CelestineOverflow/Afterburner_PCB/afterburner.kicad_pcb

## KiCad design afterburner.kicad_pcb (2025-08-22)

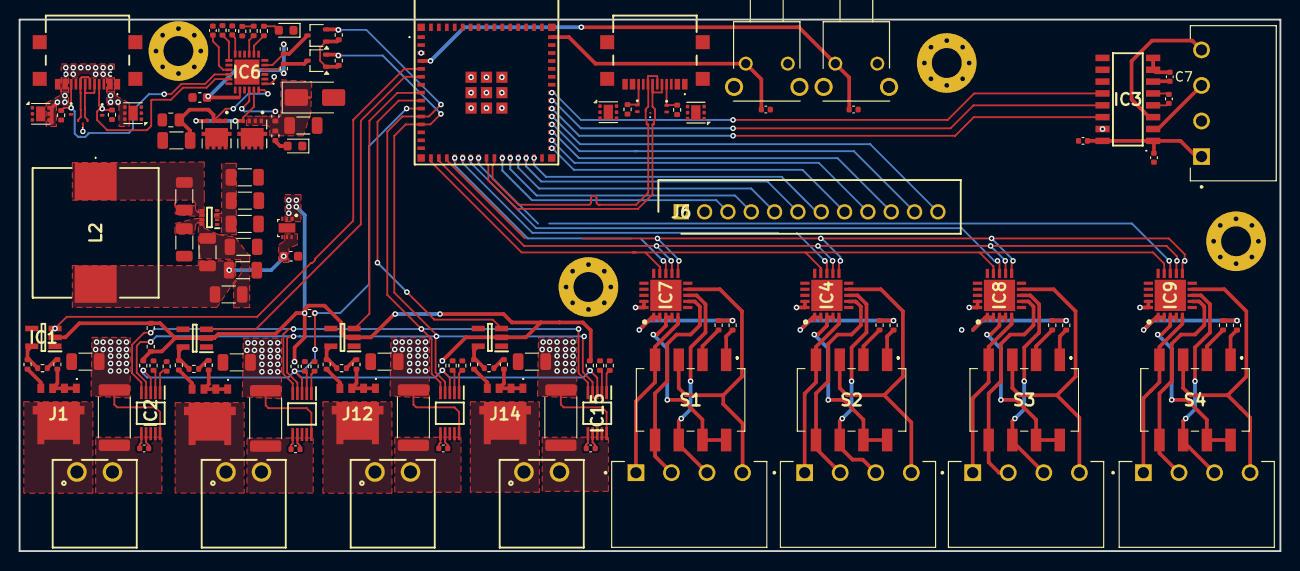
[picture p2: board afterburner.kicad_pcb from above]

Board: 4 copper layers, 135.1 x 56.9 mm, 144 parts (0 on the bottom side), 133 nets.

Parts:
C3, C16, C18, C19, C21, C23: 100nF; C_0402_1005Metric
C4, C20, C22, C24: 4.7uF; C_1206_3216Metric
C5, C6, C7, C8: 1uF; C_0402_1005Metric
C9: 10uF; C_1206_3216Metric
C10, C11: 100nF; C_1206_3216Metric
C12, C15: 10u; C_1206_3216Metric
C13, C25: 33nF; C_1206_3216Metric
C14: 15pF; C_1206_3216Metric
C17: 1u; C_0603_1608Metric
C26: 10uF; C_0603_1608Metric
C27, C28: C; C_0402_1005Metric
Cout1: 100uF; C_1206_3216Metric
D1, D2: ESD122DMYR
D3, D5: RED; LED_0603_1608Metric
D4: D_Schottky; D_SMA
H1, H2, H4, H5: MountingHole_Pad; MountingHole_3.2mm_M3_Pad_Via
IC1, IC10, IC12, IC14: MCP1416T-E_OT; SOT95P270X145-5N
IC2, IC11, IC13, IC15: INA226AIDGSR; SOP50P490X110-10N
IC3: NAU7802SGI; SOIC127P600X175-16N
IC4, IC7, IC8, IC9: MAX31865ATP+T; QFN65P500X500X80-21N
IC5: TPS62933DRLR; SOTFL50P160X60-8N
IC6: AP33772SDKZ-13-FA01; AP33772SDKZ13FA01
IC16: ESP32-S3-MINI-1-N8; ESP32S3MINI1N8
IC17: XC6220B331ER-G; XC6220B331ERG
J1, J10, J12, J14: NTMFS5C612NLT1G
J2, J11, J13, J15: 691322310002
J3, J17, J18, J19, J20: 1803293; PHOENIX_1803293
J5, J16: UJ20-C-H-G-SMT-5-P16-TR; UJ20CHGSMT5P16TR
J6: B12B-XH-A_LF__SN_; SHDR12W64P0X250_1X12_3240X575X700P
L2: SRP1250-7R8M; SRP12507R8M
Q1, Q2: BSS138; SOT-323_SC-70
R3, R33, R40, R47: 30mΩ; R_2512_6332Metric
R4, R5, R6, R7, R8, R9, R19, R26, R34, R35, R36, R37, R38, R39, R41, R42, R43, R44, R45, R46, R48, R49, R50, R51, R52, R53, R55: 10k; R_0402_1005Metric
R10, R27, R29, R31: 430; R_0402_1005Metric
R11, R28, R30, R32: 4.3k; R_0402_1005Metric
R12, R13, R14, R16, R20, R21, R22, R23, R24, R25: 5.1k; R_0402_1005Metric
R15, R54: 4.7k; R_0402_1005Metric
R17: 5m; R_0805_2012Metric
R18: 27R; R_0402_1005Metric
Rfbb1: 10k; R_1206_3216Metric
Rfbt1: 52.3k; R_1206_3216Metric
S1, S2, S3, S4: 219-4MST; 2194MST
S5, S6: 1-1825027-1; SW_1-1825027-1
TH1: Thermistor_NTC; R_0402_1005Metric
U2, U5, U6, U9: TVS2200DRV; WSON-6-1EP_2x2mm_P0.65mm_EP1x1.6mm
U3, U4, U7, U8: TPD1E05U06DPY; Texas_DPY0002A_0.6x1mm_P0.65mm
U10, U11: AON7262E; TRANS_AONR21307

Connections:
+3.3V: Q1.1 (G), Q2.1 (G), R21.1, R22.1
+3V3: C3.1, C19.1, C21.1, C23.1, IC1.2 (VDD), IC2.6 (VS), IC3.15 (DVDD), IC4.19 (DVDD), IC4.20 (VDD), IC7.19 (DVDD), IC7.20 (VDD), IC8.19 (DVDD), IC8.20 (VDD), IC9.19 (DVDD), IC9.20 (VDD), IC10.2 (VDD), IC11.6 (VS), IC12.2 (VDD), IC13.6 (VS), IC14.2 (VDD), IC15.6 (VS), IC16.3 (3V3), IC17.1 (VOUT_1), IC17.2 (VOUT_2), J6.1, R9.2, R15.2, R39.2, R46.2, R53.2, R54.2, R55.2
+5V: C14.1, C26.2, Cout1.1, IC17.3 (CE), IC17.5 (VIN_1), IC17.6 (VIN_2), L2.2, Rfbt1.1
/ALERT_INT: IC2.3 (ALERT), IC11.3 (ALERT), IC13.3 (ALERT), IC15.3 (ALERT), IC16.10 (IO6), R9.1, R39.1, R46.1, R53.1, R55.1
/D+: D1.3 (IO2), IC16.24 (IO20), J5.A6 (DP1), J5.B6 (DP2)
/D-: D1.2 (IO1), IC16.23 (IO19), J5.A7 (DN1), J5.B7 (DN2)
/HEATER_PWM_1: IC1.3 (IN), IC16.5 (IO1)
/HEATER_PWM_2: IC10.3 (IN), IC16.6 (IO2)
/HEATER_PWM_3: IC12.3 (IN), IC16.8 (IO4)
/HEATER_PWM_4: IC14.3 (IN), IC16.9 (IO5)
/Heater_Mosfet_1/IN-: IC2.9 (IN-), J2.2, R3.1
/Heater_Mosfet_1/OUT_MOS: J1.5 (D_1), J1.6 (D_2), J1.7 (D_3), J1.8 (D_4), J1.9 (D_5), J2.1
/Heater_Mosfet_2/IN-: IC11.9 (IN-), J11.2, R33.1
/Heater_Mosfet_2/OUT_MOS: J10.5 (D_1), J10.6 (D_2), J10.7 (D_3), J10.8 (D_4), J10.9 (D_5), J11.1
/Heater_Mosfet_3/IN-: IC13.9 (IN-), J13.2, R40.1
/Heater_Mosfet_3/OUT_MOS: J12.5 (D_1), J12.6 (D_2), J12.7 (D_3), J12.8 (D_4), J12.9 (D_5), J13.1
/Heater_Mosfet_4/IN-: IC15.9 (IN-), J15.2, R47.1
/Heater_Mosfet_4/OUT_MOS: J14.5 (D_1), J14.6 (D_2), J14.7 (D_3), J14.8 (D_4), J14.9 (D_5), J15.1
/LCD_BL: IC16.31 (IO35), J6.8
/LCD_CS: IC16.27 (IO47), J6.5
/LCD_DC: IC16.28 (IO33), J6.6
/LCD_RST: IC16.29 (IO34), J6.7
/LCD_SCL: IC16.26 (IO26), J6.4
/LCD_SDA: IC16.25 (IO21), J6.3
/LDCL_DRDY: IC3.12 (DRDY), IC16.38 (IO42)
/LDCL_SCLK: IC3.13 (SCLK), IC16.37 (IO41)
/LDCL_SDIO: IC3.14 (SDIO), IC16.36 (IO40)
/MCU/BOOT: C27.2, IC16.4 (IO0), S5.2
/MCU/ENABLE: C28.2, IC16.45 (EN), S6.2
/MISO: IC4.14 (SDO), IC7.14 (SDO), IC8.14 (SDO), IC9.14 (SDO), IC16.16 (IO12)
/MOSI: IC4.11 (SDI), IC7.11 (SDI), IC8.11 (SDI), IC9.11 (SDI), IC16.18 (IO14)
/PD/CC1: IC6.17 (CC1), J16.A5 (CC1), R14.1, U7.1 (I/O)
/PD/CC2: IC6.16 (CC2), J16.B5 (CC2), R16.1, U8.1 (I/O)
/PD/IFB: C16.1, IC6.15 (IFB)
/PD/NTC: IC6.13 (OTP), TH1.1
/PD/PD_INT: R25.2, R26.1
/PD/PD_INT_5V: IC6.9 (INT), R25.1
/PD/PD_LED: IC6.8 (LED), R20.1
/PD/PWR_EN: IC6.23 (PWR_EN), U10.4, U11.4
/PD/SCL_5V: IC6.5 (SCL), Q1.3 (D), R23.2
/PD/SDA_5V: IC6.4 (SDA), Q2.3 (D), R24.2
/PD/USB_N: D2.2 (IO1), J16.A7 (DN1), J16.B7 (DN2)
/PD/USB_P: D2.3 (IO2), J16.A6 (DP1), J16.B6 (DP2)
/PD/V5V: C17.1, IC6.20 (V5V), R23.1, R24.1
/PD/V18: C18.1, IC6.12 (V18)
/PD/VBUS: IC6.1 (ISENP), J16.A4 (VBUS_1), J16.B4 (VBUS_2), R17.1, U6.4 (IN), U6.5 (IN), U6.6 (IN), U9.4 (IN), U9.5 (IN), U9.6 (IN)
/PD/VBUS_SENSED: C12.1, IC6.24 (VCC), R17.2, U10.1, U10.2, U10.3
/PD/VCC: C9.2, C10.1, C15.1, C25.1, D4.1 (K), IC5.3 (VIN), R18.2, R19.1, U11.1, U11.2, U11.3
/PD/VOUT: IC6.22 (VOUT), R18.1
/SCK: IC4.12 (SCLK), IC7.12 (SCLK), IC8.12 (SCLK), IC9.12 (SCLK), IC16.17 (IO13)
/SCL: IC2.5 (SCL), IC11.5 (SCL), IC13.5 (SCL), IC15.5 (SCL), IC16.11 (IO7), Q1.2 (S), R15.1, R21.2
/SDA: IC2.4 (SDA), IC11.4 (SDA), IC13.4 (SDA), IC15.4 (SDA), IC16.12 (IO8), Q2.2 (S), R22.2, R54.1
/SS1: IC7.13 (~CS), IC16.19 (IO15)
/SS2: IC4.13 (~CS), IC16.20 (IO16)
/SS3: IC8.13 (~CS), IC16.21 (IO17)
/SS4: IC9.13 (~CS), IC16.22 (IO18)
/TP_IRQ: IC16.35 (IO39), J6.12
/TP_RST: IC16.34 (IO38), J6.11
/TP_SCL: IC16.33 (IO37), J6.10
/TP_SDA: IC16.32 (IO36), J6.9
/Temp Sensor 1/430R: R10.1, S1.2
/Temp Sensor 1/4300R: R11.1, S1.1
/Temp Sensor 1/FORCE_N: IC7.9 (FORCE-), J18.04, S1.3
/Temp Sensor 1/FORCE_P: IC7.5 (FORCE+), J18.01, S1.4
/Temp Sensor 1/ISENSOR: IC7.3 (REFIN-), IC7.4 (ISENSOR), S1.7, S1.8
/Temp Sensor 1/RTDIN_N: IC7.8 (RTDIN-), J18.03, S1.6
/Temp Sensor 1/RTDIN_P: IC7.7 (RTDIN+), J18.02, S1.5
/Temp Sensor 2/430R: R27.1, S2.2
/Temp Sensor 2/4300R: R28.1, S2.1
/Temp Sensor 2/FORCE_N: IC4.9 (FORCE-), J17.04, S2.3
/Temp Sensor 2/FORCE_P: IC4.5 (FORCE+), J17.01, S2.4
/Temp Sensor 2/ISENSOR: IC4.3 (REFIN-), IC4.4 (ISENSOR), S2.7, S2.8
/Temp Sensor 2/RTDIN_N: IC4.8 (RTDIN-), J17.03, S2.6
/Temp Sensor 2/RTDIN_P: IC4.7 (RTDIN+), J17.02, S2.5
/Temp Sensor 3/430R: R29.1, S3.2
/Temp Sensor 3/4300R: R30.1, S3.1
/Temp Sensor 3/FORCE_N: IC8.9 (FORCE-), J19.04, S3.3
/Temp Sensor 3/FORCE_P: IC8.5 (FORCE+), J19.01, S3.4
/Temp Sensor 3/ISENSOR: IC8.3 (REFIN-), IC8.4 (ISENSOR), S3.7, S3.8
/Temp Sensor 3/RTDIN_N: IC8.8 (RTDIN-), J19.03, S3.6
/Temp Sensor 3/RTDIN_P: IC8.7 (RTDIN+), J19.02, S3.5
/Temp Sensor 4/430R: R31.1, S4.2
/Temp Sensor 4/4300R: R32.1, S4.1
/Temp Sensor 4/FORCE_N: IC9.9 (FORCE-), J20.04, S4.3
/Temp Sensor 4/FORCE_P: IC9.5 (FORCE+), J20.01, S4.4
/Temp Sensor 4/ISENSOR: IC9.3 (REFIN-), IC9.4 (ISENSOR), S4.7, S4.8
/Temp Sensor 4/RTDIN_N: IC9.8 (RTDIN-), J20.03, S4.6
/Temp Sensor 4/RTDIN_P: IC9.7 (RTDIN+), J20.02, S4.5
/USB _CONTROL/CC1: J5.A5 (CC1), R12.1, U3.1 (I/O)
/USB _CONTROL/CC2: J5.B5 (CC2), R13.1, U4.1 (I/O)
/USB _CONTROL/VBUS: J5.A4 (VBUS_1), J5.B4 (VBUS_2), U2.4 (IN), U2.5 (IN), U2.6 (IN), U5.4 (IN), U5.5 (IN), U5.6 (IN)
GND: C3.2, C4.2, C5.2, C7.2, C8.2, C9.1, C10.2, C12.2, C13.1, C15.2, C16.2, C17.2, C18.2, C19.2, C20.2, C21.2, C22.2, C23.2, C24.2, C25.2, C26.1, C27.1, C28.1, Cout1.2, D1.1 (GROUND), D2.1 (GROUND), D3.1 (K), D4.2 (A), D5.1 (K), H1.1, H2.1, H4.1, H5.1, IC1.4 (GND), IC2.7 (GND), IC3.7 (REFN), IC3.8 (AVSS), IC3.9 (DVSS), IC4.6 (FORCE2), IC4.10 (GND2), IC4.15 (DGND), IC4.16 (GND1), IC4.21 (EP), IC5.4 (GND), IC6.3 (GND_1), IC6.25 (GND_2), IC7.6 (FORCE2), IC7.10 (GND2), IC7.15 (DGND), IC7.16 (GND1), IC7.21 (EP), IC8.6 (FORCE2), IC8.10 (GND2), IC8.15 (DGND), IC8.16 (GND1), IC8.21 (EP), IC9.6 (FORCE2), IC9.10 (GND2), IC9.15 (DGND), IC9.16 (GND1), IC9.21 (EP), IC10.4 (GND), IC11.7 (GND), IC12.4 (GND), IC13.7 (GND), IC14.4 (GND), IC15.7 (GND), IC16.1 (GND_1), IC16.2 (GND_2), IC16.42 (GND_3), IC16.43 (GND_4), IC16.46 (GND_5), IC16.47 (GND_6), IC16.48 (GND_7), IC16.49 (GND_8), IC16.50 (GND_9), IC16.51 (GND_10), IC16.52 (GND_11), IC16.53 (GND_12), IC16.54 (GND_13), IC16.55 (GND_14), IC16.56 (GND_15), IC16.57 (GND_16), IC16.58 (GND_17), IC16.59 (GND_18), IC16.60 (GND_19), IC16.61 (GND_20), IC16.62 (GND_21), IC16.63 (GND_22), IC16.64 (GND_23), IC16.65 (GND_24), IC16.66 (GND_25), IC16.67 (GND_26), IC16.68 (GND_27), IC16.69 (GND_28), IC16.70 (GND_29), IC16.71 (GND_30), IC16.72 (GND_31), IC16.73 (GND_32), IC17.4 (VSS), IC17.7 (EP), J3.02, J5.A1 (GND_1), J5.B1 (GND_2), J5.MP1, J5.MP2, J5.MP3, J5.MP4, J6.2, J16.A1 (GND_1), J16.B1 (GND_2), J16.MP1, J16.MP2, J16.MP3, J16.MP4, R7.2, R8.2, R12.2, R13.2, R14.2, R16.2, R26.2, R37.2, R38.2, R44.2, R45.2, R51.2, R52.2, Rfbb1.2, S5.1, S6.1, TH1.2, U2.1 (GND), U2.2 (GND), U2.3 (GND), U2.7 (GND), U3.2 (GND), U4.2 (GND), U5.1 (GND), U5.2 (GND), U5.3 (GND), U5.7 (GND), U6.1 (GND), U6.2 (GND), U6.3 (GND), U6.7 (GND), U7.2 (GND), U8.2 (GND), U9.1 (GND), U9.2 (GND), U9.3 (GND), U9.7 (GND)
unnamed: D3.2 (A), R19.2
unnamed: D5.2 (A), R20.2
unnamed: IC1.5 (OUT), R4.1, R5.1
unnamed: IC2.2 (A0), R8.1
unnamed: IC2.1 (A1), R7.1
unnamed: C5.1, C8.1, IC3.1 (REFP), IC3.16 (AVDD/LDO), J3.01
unnamed: C7.1, IC3.6 (VBG)
unnamed: IC3.2 (VIN1N), J3.03
unnamed: IC3.3 (VIN1P), J3.04
unnamed: C6.1, IC3.4 (VIN2N)
unnamed: C6.2, IC3.5 (VIN2P)
unnamed: IC4.1 (BIAS), IC4.2 (REFIN+), R27.2, R28.2
unnamed: C11.1, IC5.6 (BST)
unnamed: C14.2, IC5.8 (FB), Rfbb1.1, Rfbt1.2
unnamed: C13.2, IC5.7 (SS)
unnamed: C11.2, IC5.5 (SW), L2.1
unnamed: IC7.1 (BIAS), IC7.2 (REFIN+), R10.2, R11.2
unnamed: IC8.1 (BIAS), IC8.2 (REFIN+), R29.2, R30.2
unnamed: IC9.1 (BIAS), IC9.2 (REFIN+), R31.2, R32.2
unnamed: IC10.5 (OUT), R34.1, R35.1
unnamed: IC11.2 (A0), R38.1
unnamed: IC11.1 (A1), R37.1
unnamed: IC12.5 (OUT), R41.1, R42.1
unnamed: IC13.2 (A0), R45.1
unnamed: IC13.1 (A1), R44.1
unnamed: IC14.5 (OUT), R48.1, R49.1
unnamed: IC15.2 (A0), R52.1
unnamed: IC15.1 (A1), R51.1
unnamed: J1.4 (G), R5.2
unnamed: J1.1 (S_1), J1.2 (S_2), J1.3 (S_3), R6.2
unnamed: J10.4 (G), R35.2
unnamed: J10.1 (S_1), J10.2 (S_2), J10.3 (S_3), R36.2
unnamed: J12.4 (G), R42.2
unnamed: J12.1 (S_1), J12.2 (S_2), J12.3 (S_3), R43.2
unnamed: J14.4 (G), R49.2
unnamed: J14.1 (S_1), J14.2 (S_2), J14.3 (S_3), R50.2
unnamed: R4.2, R6.1
unnamed: R34.2, R36.1
unnamed: R41.2, R43.1
unnamed: R48.2, R50.1
VCC: C4.1, C20.1, C22.1, C24.1, IC2.8 (VBUS), IC2.10 (IN+), IC11.8 (VBUS), IC11.10 (IN+), IC13.8 (VBUS), IC13.10 (IN+), IC15.8 (VBUS), IC15.10 (IN+), R3.2, R33.2, R40.2, R47.2
