CelestineOverflow/Afterburner_PCB/(commit log)

2025-08-05 Added stuff
    [HEATER.kicad_sch, PT100.kicad_sch, USBPD.kicad_sch, USB_CONTROL.kicad_sch, USB_C_PD.kicad_sch, first_project.kicad_pcb, first_project.kicad_sch, loadcell.kicad_sch]
2025-08-11 small changes
    [HEATER.kicad_sch, PT100.kicad_sch, RotoPD.kicad_sch, USB_CONTROL.kicad_sch, first_project.kicad_pcb, first_project.kicad_sch, loadcell.kicad_sch]
2025-08-22 lots of change
    [Display.kicad_sch, HEATER.kicad_sch, MCU.kicad_sch, Mechanical.kicad_sch, PD.kicad_sch, PT100.kicad_sch, afterburner.csv, afterburner.kicad_pcb]
